lukr21/Portable-Speaker-Project/Audio Visualizer/Docs/vu_ladder_designer.html

# Loudness Ladder — LED VU Meter

Envelope detector → ×2.1 op amp bus → N common-emitter NPN stages, each with its own Rtop/Rbot base divider. LEDs light in sequence as loudness rises; the top LED doubles as a clip indicator.

rail +12 V gain ×2.1 (Rf 11k / Rg 10k) op amp clips 10.5 V (Vdet = 5.0 V) full scale 10.5 V bus Vbe 0.65 V Vdet peaks 6 V

## Design controls

LEDs N (3–20) Dynamic range (dB below full scale) E-series LED Vf (V) LED current Iled (mA) Anchor mode Rtop = 10 k Search both Show tolerance shift

## Simulation — slide the detector voltage; op amp output = min(2.1·Vdet, 10.5 V)

Vdet

## Divider design table — worst-error stage highlighted

## Collector resistor & BOM

Copy values as text

## One stage + front end

show values for stage
