lukr21/Portable-Speaker-Project/Audio Visualizer/Images/Render Back V1.png

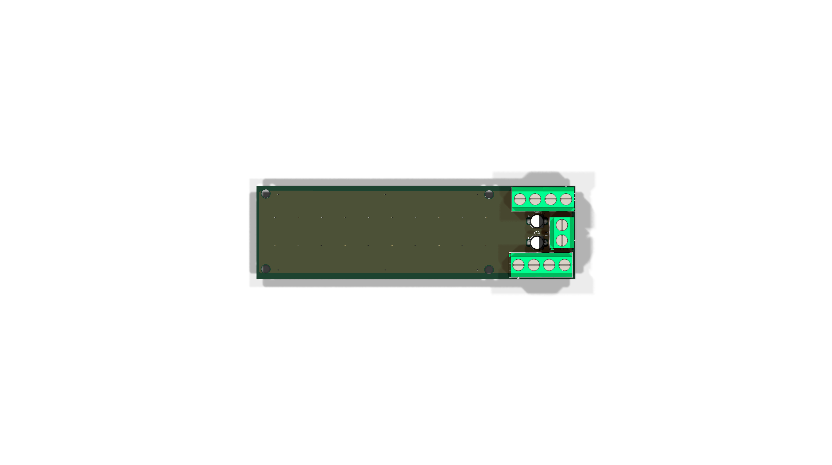
Audio Visualizer/Images/Render Back V1.png
