lukr21/Portable-Speaker-Project/Audio Visualizer/Images/Render Corner V1.png

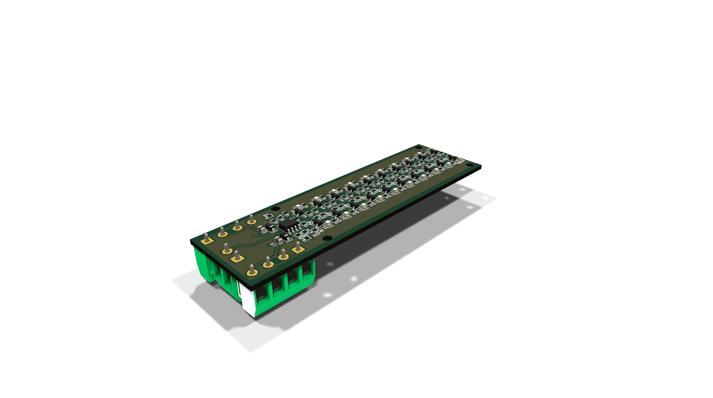
Audio Visualizer/Images/Render Corner V1.png
