lukr21/Portable-Speaker-Project/Audio Visualizer/Images/Render Top V1 shadow.png

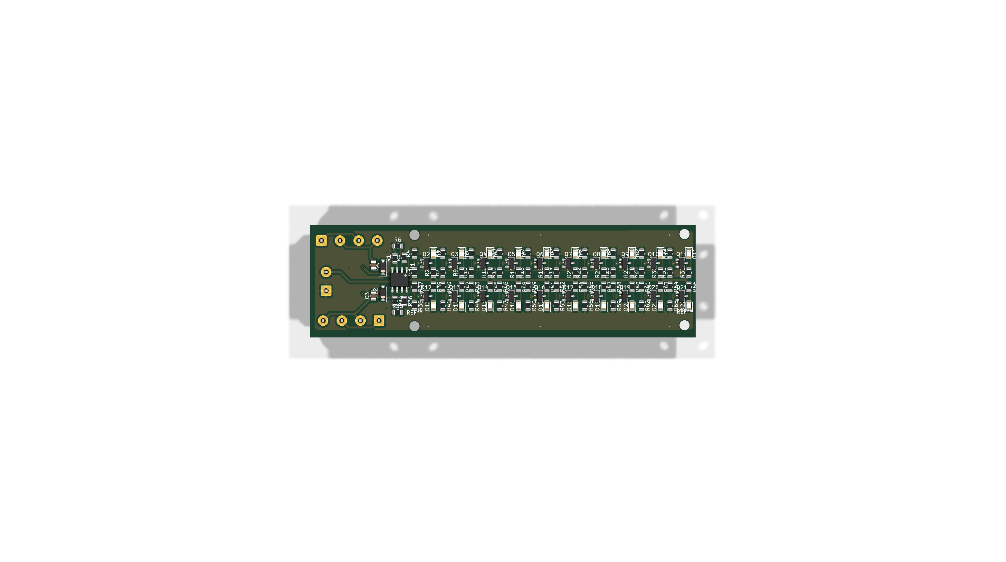
Audio Visualizer/Images/Render Top V1 shadow.png
