lukr21/Portable-Speaker-Project/Audio Visualizer/Images/Render Top V1.png

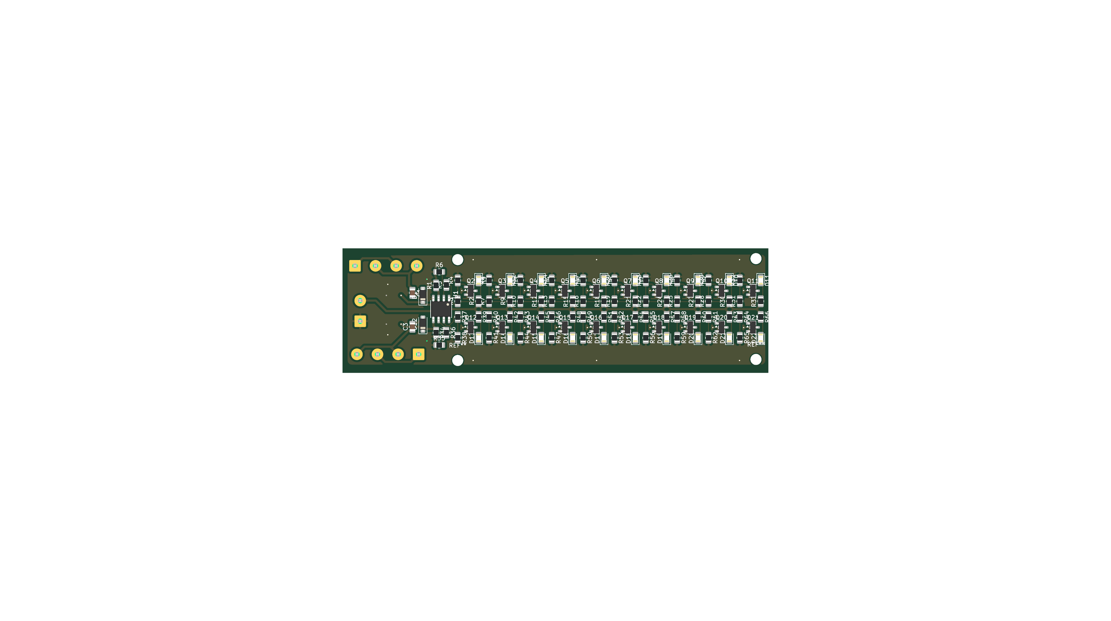
Audio Visualizer/Images/Render Top V1.png
