lukr21/Portable-Speaker-Project/Speaker Amp/Images/Render Corner V1 models.png

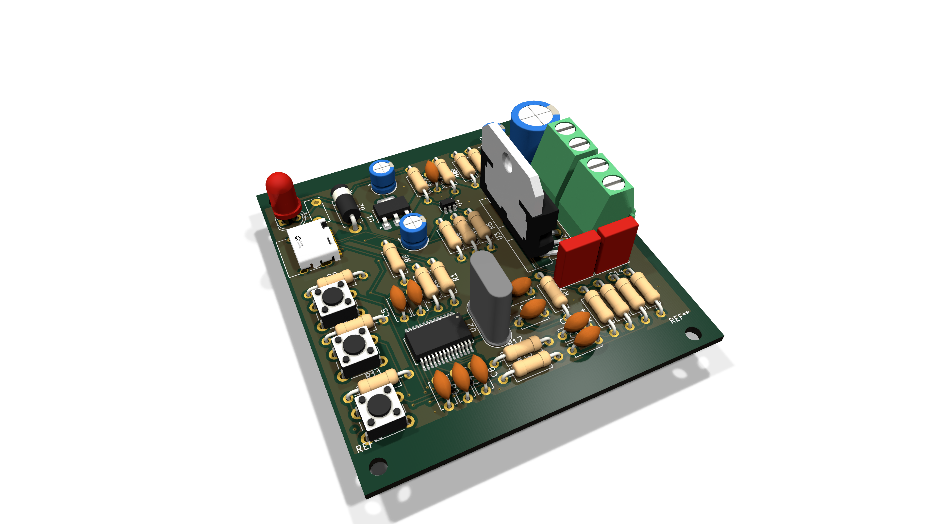
Speaker Amp/Images/Render Corner V1 models.png
