lukr21/Portable-Speaker-Project/Speaker Amp/Images/Render Top V1 models.png

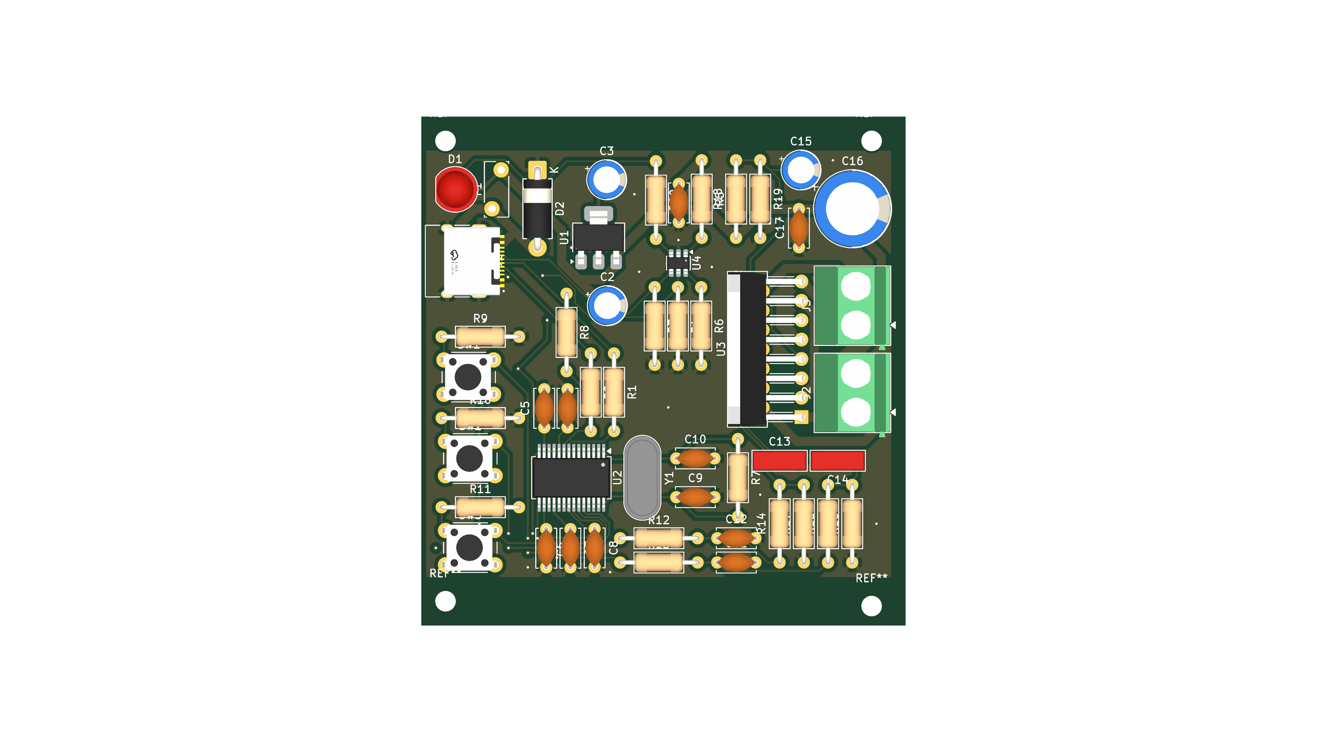
Speaker Amp/Images/Render Top V1 models.png
