lukr21/Portable-Speaker-Project/Speaker Amp/Images/Render Top V2 transparent.png

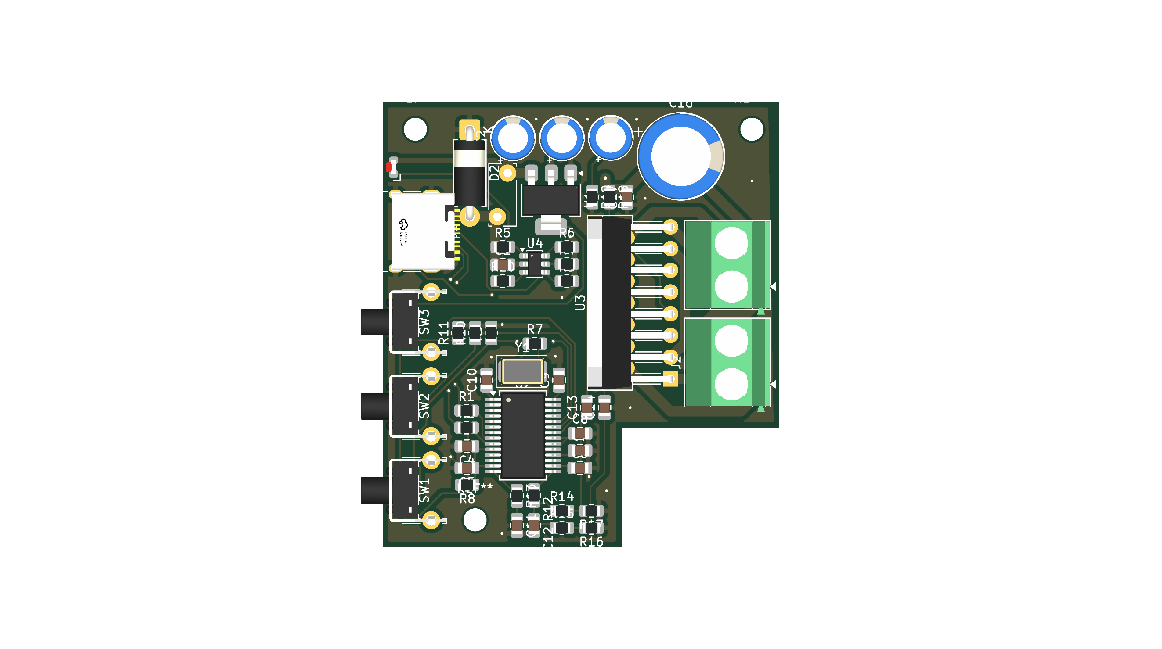
Speaker Amp/Images/Render Top V2 transparent.png
