lukr21/Portable-Speaker-Project/Speaker Amp/Images/Render Top V3.png

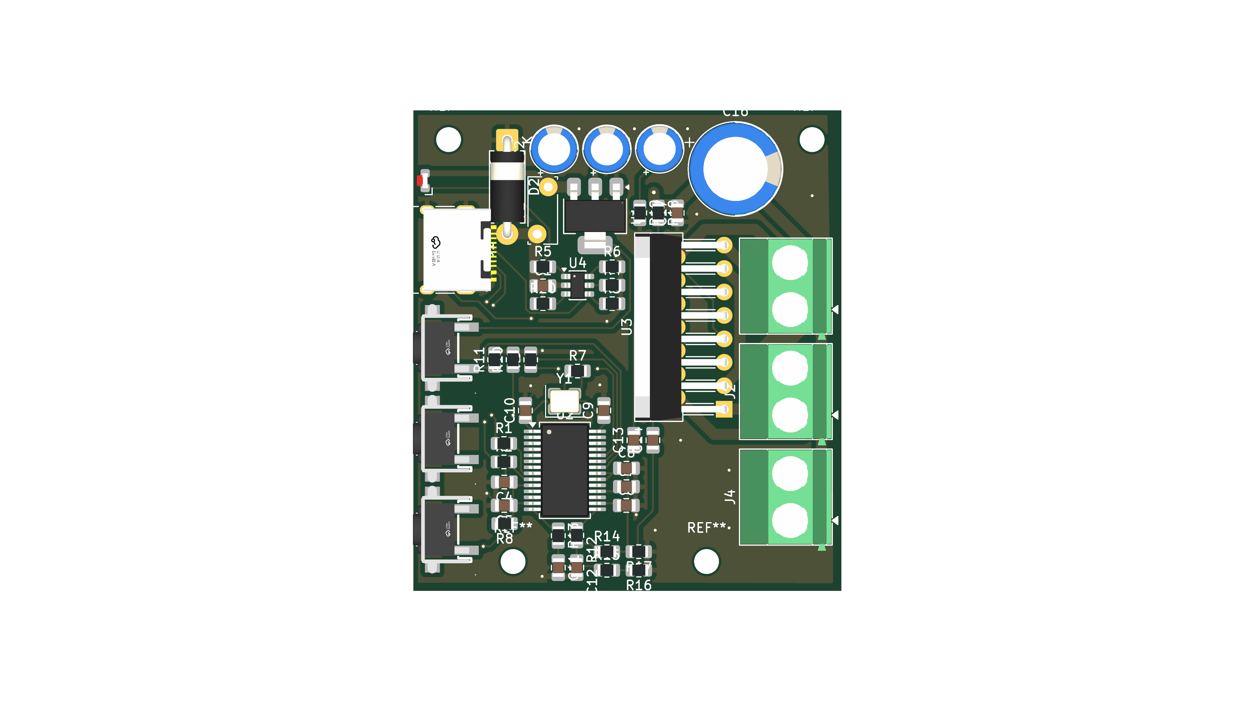
Speaker Amp/Images/Render Top V3.png
