lukr21/Portable-Speaker-Project/Speaker Amp/Images/Render Top V4.png

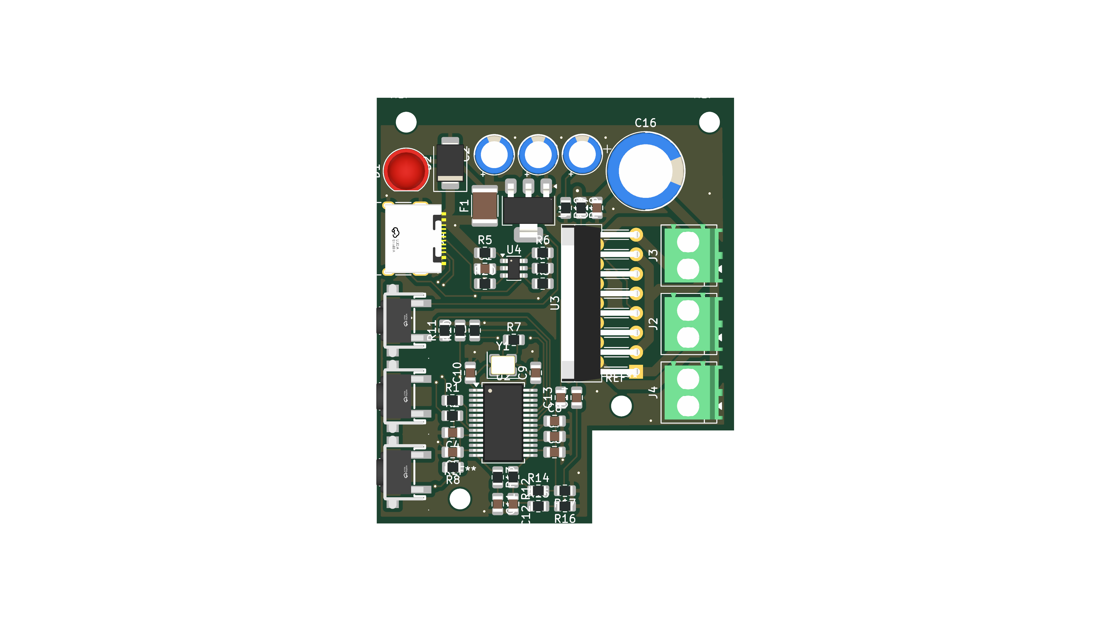
Speaker Amp/Images/Render Top V4.png
