lukr21/Portable-Speaker-Project/.step

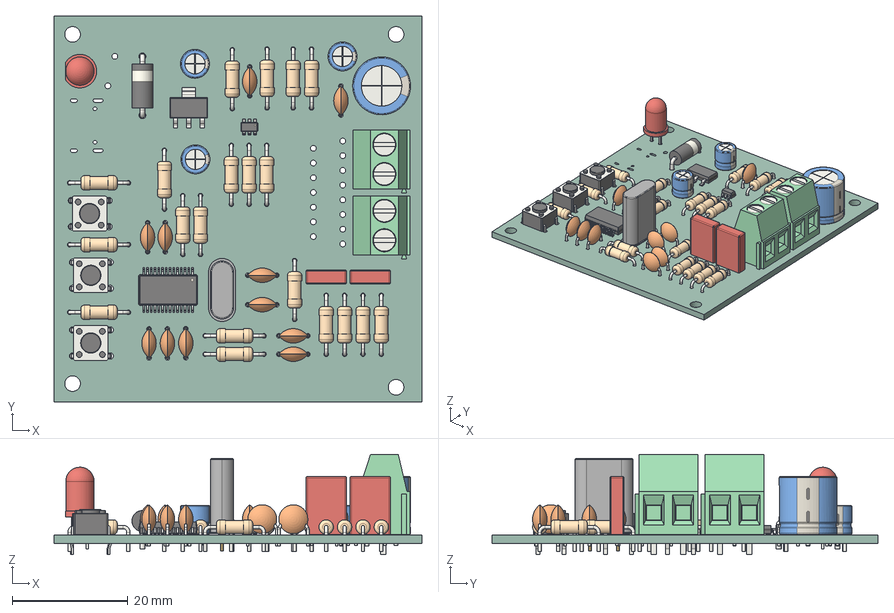
[picture p16: CAD file, 2026-07-06]
.step
63.5 x 66.7 x 17.3 mm
SOT-223
R_Axial_DIN0207_L63mm_D25mm_P1016mm_Horizontal x 20
C_Disc_D50mm_W25mm_P500mm x 11
SW_PUSH_6mm x 3
TerminalBlock_Phoenix_MKDS-1,5-2-5.08_1x02_P5.08mm_Horizontal x 2
CP_Radial_D50mm_P200mm x 3
SSOP-28_5.3x10.2mm_P0.65mm
C_Rect_L70mm_W25mm_P500mm x 2
Crystal_HC49-U_Vertical
SOT-23-6
LED_D5.0mm
CP_Radial_D100mm_P500mm
D_DO-15_P10.16mm_Horizontal
First Project Speaker-unsaved-export-jiPnWW_PCB
