lukr21/Portable-Speaker-Project/Audio Visualizer/3dmodels/CONN-TH_2P-P5.00_MX126-5.0-GN01-02P-CU-S-A.step

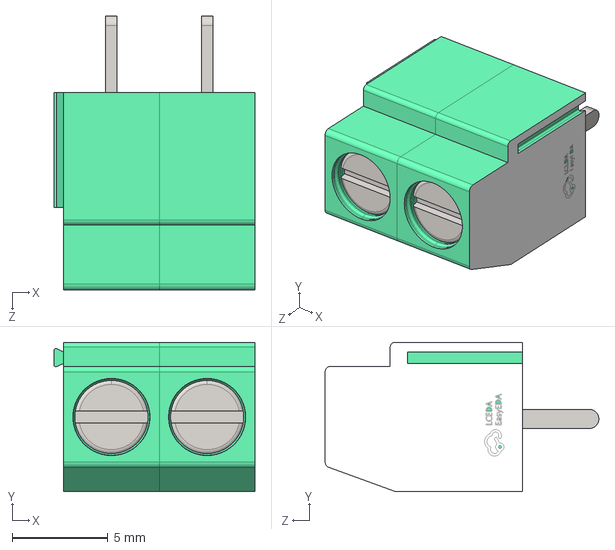
[picture p17: CAD file, 2026-07-07]
Audio Visualizer/3dmodels/CONN-TH_2P-P5.00_MX126-5.0-GN01-02P-CU-S-A.step
10.5 x 7.80 x 14.3 mm
