lukr21/Portable-Speaker-Project/Audio Visualizer/Audio Visualizer V2.step

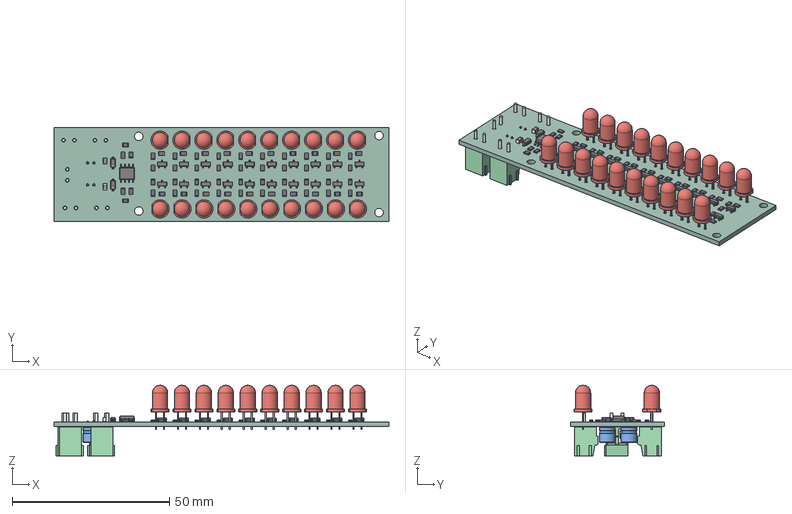
[picture p18: CAD file, 2026-07-08]
Audio Visualizer/Audio Visualizer V2.step
106.7 x 29.8 x 22.5 mm
R_0805_2012Metric x 66
SOT-23 x 20
LED_D5.0mm x 20
SOIC-8_3.9x4.9mm_P1.27mm
D_SOD-123 x 2
C_0805_2012Metric x 2
CP_Radial_D50mm_P200mm x 2
TerminalBlock_Phoenix_PT-1,5-2-3.5-H_1x02_P3.50mm_Horizontal x 5
Audio Visualizer_PCB
