lukr21/Portable-Speaker-Project/Drivers/Dayton CE81PF-8 driver.step

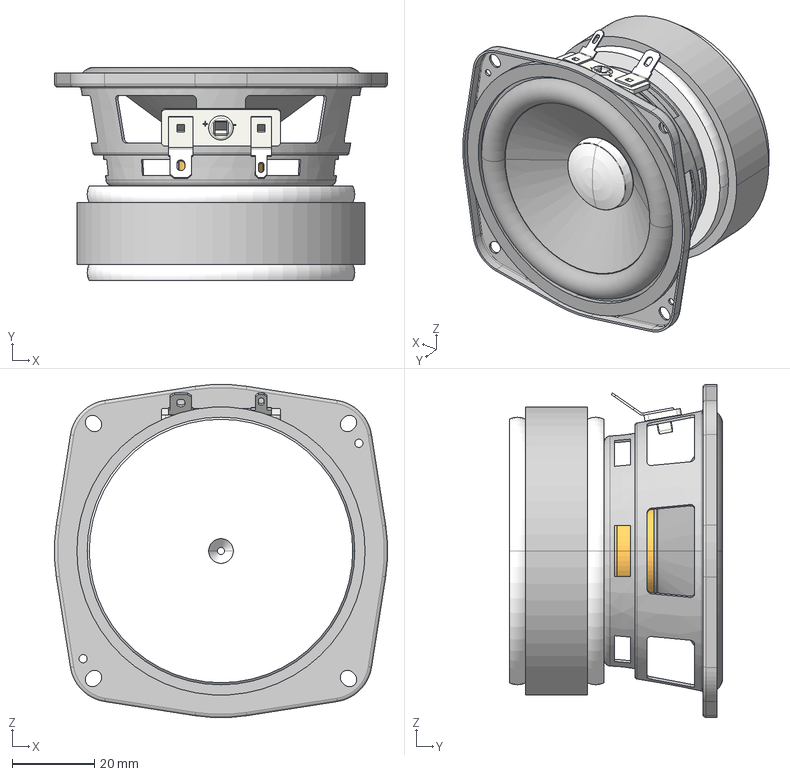
[picture p19: CAD file, 2026-07-08]
Drivers/Dayton CE81PF-8 driver.step
80.9 x 51.9 x 80.9 mm
HF-1
HP_1
HM_1
HY_1
HV_1
HC-1_1
HD_1
TY-01
