lukr21/Portable-Speaker-Project/Speaker Amp/3dmodels/SW-SMD_XUNPU_TS-1005B-AR045XX.step

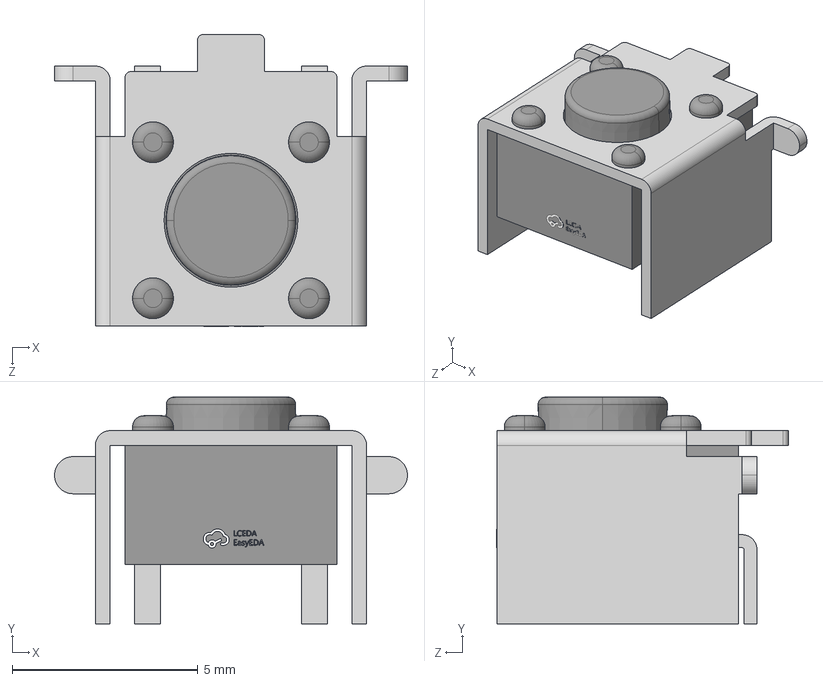
[picture p20: CAD file, 2026-07-07]
Speaker Amp/3dmodels/SW-SMD_XUNPU_TS-1005B-AR045XX.step
9.50 x 6.10 x 7.86 mm
