lukr21/Portable-Speaker-Project/Speaker Amp/3dmodels/USB-C_SMD-TYPE-C-31-M-12_1.step

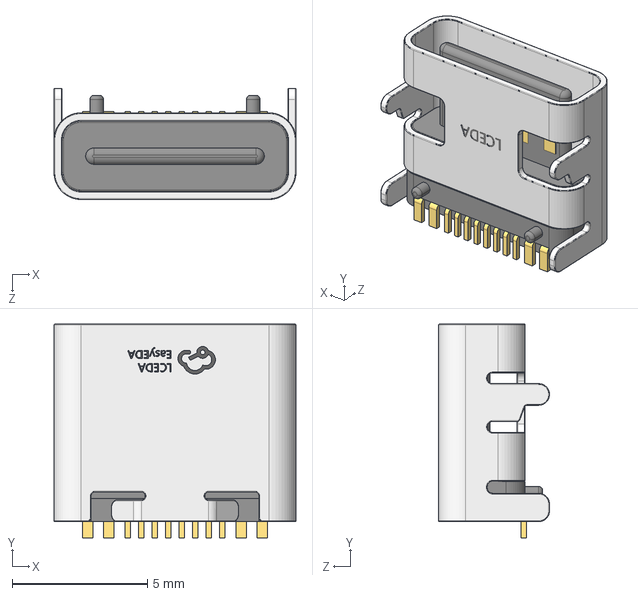
[picture p22: CAD file, 2026-07-07]
Speaker Amp/3dmodels/USB-C_SMD-TYPE-C-31-M-12_1.step
8.94 x 7.90 x 4.10 mm
