lukr21/Portable-Speaker-Project/Speaker Amp/3dmodels/MULTIWATT-15_L19.6-W5.0-P1.27-L.step

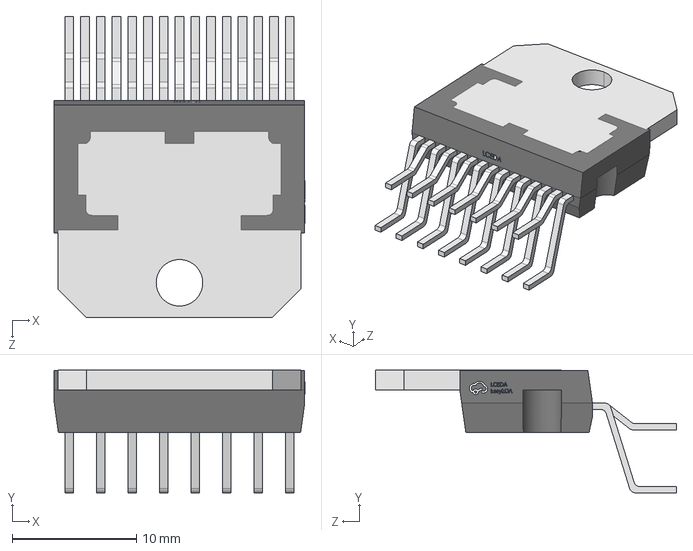
[picture p23: CAD file, 2026-07-07]
Speaker Amp/3dmodels/MULTIWATT-15_L19.6-W5.0-P1.27-L.step
20.2 x 9.89 x 24.3 mm
