lukr21/Portable-Speaker-Project/(list of files, cad)

Other CAD files:
Speaker Amp/SpeakerPCB.step
