lukr21/Portable-Speaker-Project/(commit log)

2026-07-06 First Project Speaker: USB-C powered stereo speaker board (v1, DRC-clean except accepted thermal reliefs)
    [.step, First Project Speaker.kicad_pcb, First Project Speaker.kicad_sch, SpeakerPCB.step]
2026-07-07 V2: SMD/0805 passives, side buttons, envelope-detector visualizer planning
    [First Project Speaker.kicad_pcb, First Project Speaker.kicad_sch, MULTIWATT-15_L19.6-W5.0-P1.27-L.step, USB-C_SMD-TYPE-C-31-M-12_1.step]
2026-07-07 V2: U3 3D model fix, high-res transparent renders, plotted PCB layout images
    [First Project Speaker.kicad_pcb]
2026-07-07 V3: add J4 screw terminal for external audio visualizer PCB, extend board outline, V3 renders
    [First Project Speaker.kicad_pcb, First Project Speaker.kicad_sch]
2026-07-07 Re-render all V1/V2/V3 board images at 4K
2026-07-07 Restructure repo: Speaker Amp + Audio Visualizer as sibling projects
    - Move repo root up to Speaker Project/ umbrella folder
    - Rename 'First Project Speaker' to 'Speaker Amp' (folder and KiCad files)
    - Add Audio Visualizer PCB project (BJT VU ladder, 20-LED) with terminal
    block 3D models and V1 renders
    [.step, Audio Visualizer.kicad_pcb, Audio Visualizer.kicad_sch, CONN-TH_2P-P5.00_MX126-5.0-GN01-02P-CU-S-A.step, MULTIWATT-15_L19.6-W5.0-P1.27-L.step, Speaker Amp.kicad_pcb, Speaker Amp.kicad_sch, SpeakerPCB.step]
2026-07-07 Audio Visualizer: move terminal blocks and electrolytics to back side
    Front face now flush for the LED ladder. THT terminals flipped with pads
    kept on the same holes/nets; SMD electrolytics reconnected to front
    traces with a via per pad; GND zones refilled. DRC: 0 errors,
    0 unconnected. Adds back-side render.
    [Audio Visualizer.kicad_pcb]
2026-07-07 Audio Visualizer: face terminal block openings outward
    Rotated J1/J2/J3 180deg about their pad rows (pin order reverses on the
    holes) and swapped the matching net labels in the schematic (IN_L+/-,
    IN_R+/-, +12V/GND) so every hole keeps its original net. Zones
    refilled. DRC: 0 errors, 0 unconnected, 0 parity. All renders redone.
    [Audio Visualizer.kicad_pcb, Audio Visualizer.kicad_sch]
2026-07-07 Speaker Amp: rename cap values .022u/.22u to 22n/220n for fab BOM compatibility
    [Speaker Amp.kicad_pcb, Speaker Amp.kicad_sch]
2026-07-07 Audio Visualizer: encode VU ladder LED colors (5 green, 4 orange, 1 red per row)
    [Audio Visualizer.kicad_pcb, Audio Visualizer.kicad_sch, BOM_JLC.csv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]
2026-07-07 Speaker Amp: JLC-stockable parts - 3225 crystal, XUNPU TS-1005B SMD side buttons
    Y1 swapped to 2-pin-mapped 3225 footprint (basic-part crystals); SW1-SW3
    swapped to SMD side-press switches (LCSC C2856783, machine-assembled),
    rotated to face the board edge with bracket anchors at the edge. 3.3V
    button rail moved to a B.Cu pad-via rail; HID1/HID2 rerouted on B.Cu
    around the USB differential pair. DRC: 0 errors, 0 unconnected, 0 parity.
    [Audio Visualizer.kicad_pcb, Audio Visualizer.kicad_sch, SW-SMD_XUNPU_TS-1005B-AR045XX.step, Speaker Amp.kicad_pcb, Speaker Amp.kicad_sch]
2026-07-07 Speaker Amp: user trace cleanup, zones refilled, renders and fab package regenerated
    [Speaker Amp.kicad_pcb]
2026-07-07 Speaker Amp: disc-cap stand-in 3D model for F1 polyfuse (no vendor CAD exists)
    [BOM_JLC.csv, Speaker Amp.kicad_pcb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]
2026-07-08 Audio Visualizer: JLC fab BOM/CPL working files (all-SMD V1)
    [BOM_JLC.csv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]
2026-07-08 Audio Visualizer: convert hand-solder parts to Detkin THT
    - 20 ladder LEDs 0805 -> LED_THT:LED_D5.0mm (5mm, Detkin stock)
    - C2/C4 10u electrolytics CP_Elec_4x5.4 -> CP_Radial_D5.0mm_P2.00mm (user's 100V BPSM2316)
    - J1/J2 MX126 4P split into 2P pairs J4-J7 (user's schematic edit),
    all terminals incl. J3 now 4Ucon 1x02 3.5mm KF350-style (Detkin stock)
    - zones refilled; DRC delta vs v1-smd: only stock-footprint courtyard/clearance
    notes from 5mm domes over SOT-23s, no new electrical violations
    [Audio Visualizer.kicad_pcb, Audio Visualizer.kicad_sch]
2026-07-08 Audio Visualizer V2: THT re-layout routed, 4K renders
    - User re-layout: replicated cluster ladder at 6.985mm pitch, rails routed
    - Two missing +12V stubs on template cluster (R2, R39) added; DRC now fully
    clean: 0 violations, 0 unconnected
    - J3-J7 terminals use shipped Phoenix PT-1,5 3.5mm step model (4Ucon has none)
    - V2 image set: Top / Top shadow / Corner / Back / PCB Layout
    [Audio Visualizer.kicad_pcb, Audio Visualizer.kicad_sch]
2026-07-08 Audio Visualizer: fix layer draw order in PCB Layout V2 (F.Cu on top)
2026-07-08 Speaker Amp: swap 5.08mm Phoenix terminals to 3.5mm 4Ucon (Detkin stock)
    In-place footprint swap for J2/J3/J4, pads recentered on the old blocks,
    nets preserved, Phoenix PT-1,5 step model attached (no 4Ucon model ships).
    Electrolytics already matched the user's THT caps. DRC unchanged: only the
    accepted R6 starved-thermal.
    [Speaker Amp.kicad_pcb, Speaker Amp.kicad_sch]
2026-07-08 Speaker Amp V4: JLC-mountable protection parts, THT indicator LED
    - D2: P6KE16A DO-15 -> SMBJ15A SMB (JLC Preferred C19077569); schematic
    symbol rotated so the cathode pad lands on VBUS_RAW for assembly polarity
    - F1: Bourns MF-RG300 radial -> SMD1812P300TF/16 3A/16V 1812 (C702820);
    C_1812 chip step model as stand-in (no 1812 fuse model ships)
    - D1: APA1606 side LED -> LED_THT:LED_D5.0mm (Detkin stock, matches visualizer)
    - User rework of the power-entry routing; one missing VBUS_RAW F/B via
    restored where the old D2 through-hole used to bridge layers
    - DRC: 0 violations except accepted R6 starved-thermal, 0 unconnected
    - V4 render set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
    [Speaker Amp.kicad_pcb, Speaker Amp.kicad_sch]
2026-07-08 Regenerate JLCPCB fab packages: Visualizer V2, Speaker Amp V4
    Fresh gerbers/drill, BOM and CPL from the current boards, updated READMEs.
    Both DRC-clean with 0 unconnected and 0 schematic parity issues. D2 board
    value synced to SMBJ15A. Versioned zips are local-only (gitignored).
    [BOM_JLC.csv, Speaker Amp.kicad_pcb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]
2026-07-08 Audio Visualizer: all-Basic resistor ladder (free Rtop/Rk pairs)
    Ladder recalculated per stage from JLC's Basic 0805 catalog with both
    divider resistors free; same -22.5..0dB / 2.5dB thresholds. Worst error
    improves 3.8% -> 1.4%; op-amp load drops ~9.9 -> ~6.5mA per channel.
    Gain 2.1 rebuilt as 1 + 22k/20k (11k was Extended). 36 value changes in
    sch + PCB, no layout changes. Docs updated (user), fab package folders
    restructured to JLCPCB_*_V2/V4 and visualizer package regenerated.
    [Audio Visualizer.kicad_pcb, Audio Visualizer.kicad_sch, BOM_JLC.csv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]
2026-07-08 Speaker Amp: Basic-catalog U1/Y1, fab package refresh
    - U1: LD1117S33 -> AMS1117-3.3 (C6186, Basic, pin-compatible SOT-223)
    - Y1: explicit LCSC C9002 (12MHz 3225, Basic) so the matcher stops
    whiffing on the custom 2-pin-remapped footprint name
    - D2 C19077569 confirmed on JLC's Preferred list (no fee despite the
    Extended label in the matcher UI)
    - Remaining fee-carrying Extended: F1, J1, SW1-3, U2, U4 (+U3 unless DNP)
    [BOM_JLC.csv, Speaker Amp.kicad_pcb, Speaker Amp.kicad_sch]
2026-07-08 STEP exports of both boards for enclosure design
    [Audio Visualizer V2.step]
2026-07-08 Terminals flipped to face outward (user rework), renders/STEPs regenerated
    User rotated and repositioned all eight screw terminals so wire entries
    face the board edges; copper reworked accordingly, DRC/parity clean on
    both boards. All render sets, layout PNGs, and STEP files regenerated.
    [Audio Visualizer V2.step, Audio Visualizer.kicad_pcb]
2026-07-08 As-ordered STEP files: ordered copper + terminals shown flipped-in-place
    The fab order used the pre-rework gerbers (terminals at old positions,
    to be physically rotated 180deg at assembly). These STEPs show exactly
    that hardware for enclosure design. The plain V2/V4 STEPs describe the
    reworked next-rev boards.
    [Audio Visualizer V2 as-ordered.step]
2026-07-08 Audio Visualizer: mount screw terminals J3-J7 on underside
    Flipped the five 3.5mm terminal blocks to B.Cu so the LED/top face sits
    flush (e.g. against the front panel), wires now enter from the back into
    the enclosure. THT holes and nets unchanged -> traces untouched, schematic
    parity clean, DRC 0/0. Renders, layout, and STEP regenerated.
    NOTE: diverges from the already-ordered boards (terminals top-side); this
    is next-rev / enclosure-design geometry. Fab packages intentionally NOT
    regenerated.
    [Audio Visualizer V2.step, Audio Visualizer.kicad_pcb]
2026-07-08 Add Dayton CE81PF-8 official STEP model + spec sheet for enclosure design
    [Dayton CE81PF-8 driver.step]
2026-07-08 Audio Visualizer: move C2/C4 10uF electrolytics to underside too
    Flipped the two THT radials to B.Cu alongside the terminals so the top
    face carries only the LED ladder + SMD parts (maximally flush). Polarity
    preserved (parity clean), holes/nets unchanged, DRC 0/0/0, no courtyard
    collisions with the bottom-side terminals. Renders + STEP regenerated.
    [Audio Visualizer V2.step, Audio Visualizer.kicad_pcb]
